machinedeck/RADMEP-JYU---Visible-Light-Communication-with-LED-and-Photoresistor/Photoresistor Characterization/12kohms_with_blink_dark.csv

#Digilent WaveForms Oscilloscope Acquisition
#Device Name: Discovery2
#Serial Number: SN:210321ABEE3D
#Date Time: 2023-11-30 06:35:25.732
#Sample rate: 800Hz
#Samples: 17125
#Trigger: Source: Channel 1 Type: Edge Condition: Rising Level: 0 V Hyst.: Auto HoldOff: 0 s
#Channel 1: Range: 1 V/div Offset: 0 V Attenuation: 1 X Sample Mode: Average
#Channel 2: Range: 500 mV/div Offset: 0 V Attenuation: 1 X Sample Mode: Average
Time (s) | Channel 1 (V) | Channel 2 (V)
-163.84 | 0.006563609919823729 | -0.0006359147271907438
-163.83875 | 0.02519822337511149 | -0.000972419238711277
-163.8375 | 0.02519822337511149 | -0.000972419238711277
-163.83625 | 0.02519822337511149 | -0.0006359147271907438
-163.835 | 0.02519822337511149 | -0.0002994102156702108
-163.83375 | 0.02519822337511149 | 3.709429585032226e-05
-163.8325 | 0.02519822337511149 | 3.709429585032226e-05
-163.83125 | 0.02519822337511149 | 0.0003735988073659585
-163.83 | 0.02519822337511149 | 0.0003735988073708553
-163.82875 | 0.02519822337511149 | 0.0003735988073708553
-163.8275 | 0.02519822337511149 | 3.709429584542548e-05
-163.82625 | 0.02519822337511149 | -0.0002994102156751076
-163.825 | 0.02519822337511149 | -0.0006359147271907438
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
