machinedeck/RADMEP-JYU---Visible-Light-Communication-with-LED-and-Photoresistor/Photoresistor Characterization/12kohms_with_blink_light.csv

#Digilent WaveForms Oscilloscope Acquisition
#Device Name: Discovery2
#Serial Number: SN:210321ABEE3D
#Date Time: 2023-11-30 06:33:22.274
#Sample rate: 800Hz
#Samples: 17112
#Trigger: Source: Channel 1 Type: Edge Condition: Rising Level: 0 V Hyst.: Auto HoldOff: 0 s
#Channel 1: Range: 1 V/div Offset: 0 V Attenuation: 1 X Sample Mode: Average
#Channel 2: Range: 500 mV/div Offset: 0 V Attenuation: 1 X Sample Mode: Average
Time (s) | Channel 1 (V) | Channel 2 (V)
-163.84 | 0.7333135346760464 | -0.0002994102156702108
-163.83875 | 2.648951797879628 | 3.709429585032226e-05
-163.8375 | 2.652678720570686 | 0.0003735988073708553
-163.83625 | 2.652678720570686 | 0.0007101033188913885
-163.835 | 2.652678720570686 | 0.0003735988073708553
-163.83375 | 2.652678720570686 | 0.0007101033188913885
-163.8325 | 2.648951797879682 | 0.0003735988073757521
-163.83125 | 2.648951797879628 | 3.709429585521906e-05
-163.83 | 2.648951797879628 | -0.0006359147271809502
-163.82875 | 2.652678720570631 | -0.0006359147271907438
-163.8275 | 2.652678720570686 | -0.0006359147271907438
-163.82625 | 2.652678720570686 | -0.0006359147271907438
-163.825 | 2.652678720570686 | -0.0006359147271956406
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
