machinedeck/RADMEP-JYU---Visible-Light-Communication-with-LED-and-Photoresistor/Photoresistor Characterization/20kohms_with_blink_light.csv

#Digilent WaveForms Oscilloscope Acquisition
#Device Name: Discovery2
#Serial Number: SN:210321ABEE3D
#Date Time: 2023-11-30 06:20:23.815
#Sample rate: 800Hz
#Samples: 21027
#Trigger: Source: Channel 1 Type: Edge Condition: Rising Level: 0 V Hyst.: Auto HoldOff: 0 s
#Channel 1: Range: 1 V/div Offset: 0 V Attenuation: 1 X Sample Mode: Average
#Channel 2: Range: 500 mV/div Offset: 0 V Attenuation: 1 X Sample Mode: Average
Time (s) | Channel 1 (V) | Channel 2 (V)
-163.84 | 0.6438673900906651 | -0.0002994102156702108
-163.83875 | 3.304890191505757 | -0.0002994102156702108
-163.8375 | 3.304890191505757 | -0.0006359147271907438
-163.83625 | 3.304890191505757 | -0.0006359147271907438
-163.835 | 3.308617114196815 | -0.000972419238711277
-163.83375 | 3.308617114196815 | -0.000972419238711277
-163.8325 | 3.308617114196815 | -0.000972419238711277
-163.83125 | 3.304890191505812 | -0.000972419238711277
-163.83 | 3.304890191505757 | -0.0006359147271956406
-163.82875 | 3.304890191505757 | -0.0002994102156751076
-163.8275 | 3.304890191505757 | 3.709429585032226e-05
-163.82625 | 3.304890191505812 | 3.709429585521905e-05
-163.825 | 3.308617114196815 | 0.0003735988073708553
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
