machinedeck/RADMEP-JYU---Visible-Light-Communication-with-LED-and-Photoresistor/Photoresistor Characterization/470ohms_with_blink_light.csv

#Digilent WaveForms Oscilloscope Acquisition
#Device Name: Discovery2
#Serial Number: SN:210321ABEE3D
#Date Time: 2023-11-30 06:27:39.336
#Sample rate: 800Hz
#Samples: 17697
#Trigger: Source: Channel 1 Type: Edge Condition: Rising Level: 0 V Hyst.: Auto HoldOff: 0 s
#Channel 1: Range: 1 V/div Offset: 0 V Attenuation: 1 X Sample Mode: Average
#Channel 2: Range: 500 mV/div Offset: 0 V Attenuation: 1 X Sample Mode: Average
Time (s) | Channel 1 (V) | Channel 2 (V)
-163.84 | 0.06619437297674456 | -0.0002994102156702108
-163.83875 | 0.1966366671637589 | -0.0002994102156702108
-163.8375 | 0.1966366671637589 | 3.709429585032226e-05
-163.83625 | 0.1966366671637589 | 3.709429585032226e-05
-163.835 | 0.1966366671637589 | 3.709429585032226e-05
-163.83375 | 0.1966366671637589 | 3.709429585032226e-05
-163.8325 | 0.1966366671637589 | 3.709429585032226e-05
-163.83125 | 0.1966366671637589 | -0.000299410215665314
-163.83 | 0.1966366671637589 | -0.000635914727185847
-163.82875 | 0.1966366671637589 | -0.0006359147271907438
-163.8275 | 0.1966366671637589 | -0.0006359147271956406
-163.82625 | 0.1966366671637589 | -0.0009724192387063802
-163.825 | 0.1966366671637589 | -0.0006359147271956406
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
