machinedeck/RADMEP-JYU---Visible-Light-Communication-with-LED-and-Photoresistor/Photoresistor Characterization/img2.jpg

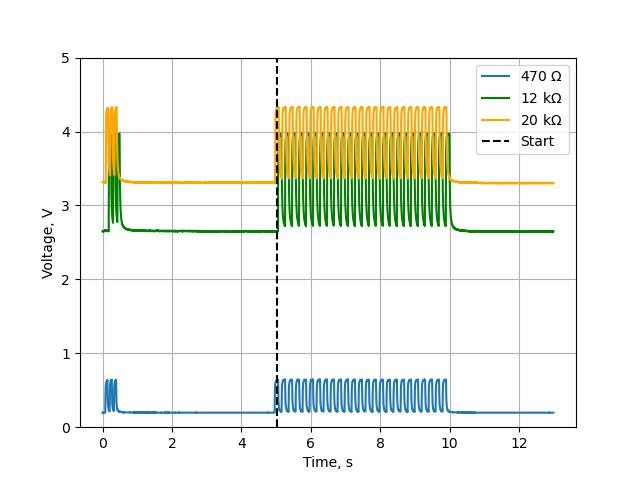
Photoresistor Characterization/img2.jpg
