machinedeck/RADMEP-JYU---Visible-Light-Communication-with-LED-and-Photoresistor/(commit log)

2025-11-06 photoresistor data
    # Photoresistor Characterization
    This contains the data of the photoresistor response to LED blinks measured using Analog Discovery 2.
    [12kohms_with_blink_dark.csv, 12kohms_with_blink_light.csv, 20kohms_with_blink_dark.csv, 20kohms_with_blink_light.csv, 470ohms_with_blink_dark.csv, 470ohms_with_blink_light.csv, for_switch_response_12kohms.csv]
2025-11-07 Python-Arduino interfacing
